ilisparrow/ProjetTPcapteur/Construction robot/montage_acc.jpg

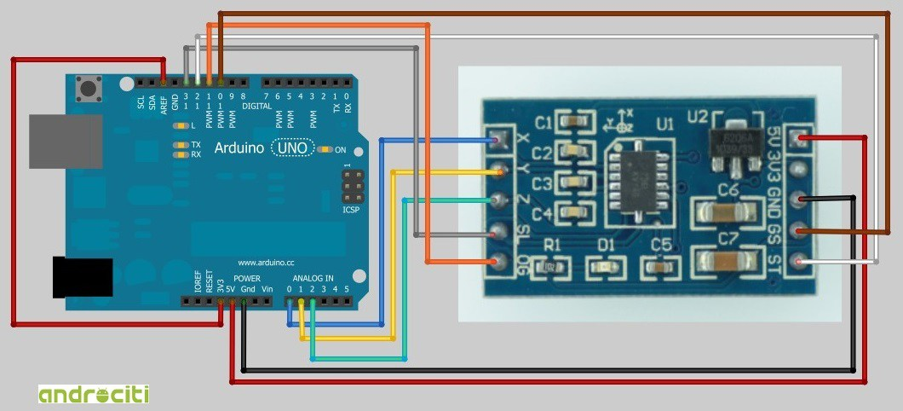
Construction robot/montage_acc.jpg
