ilisparrow/ProjetTPcapteur/Construction robot/4.jpg

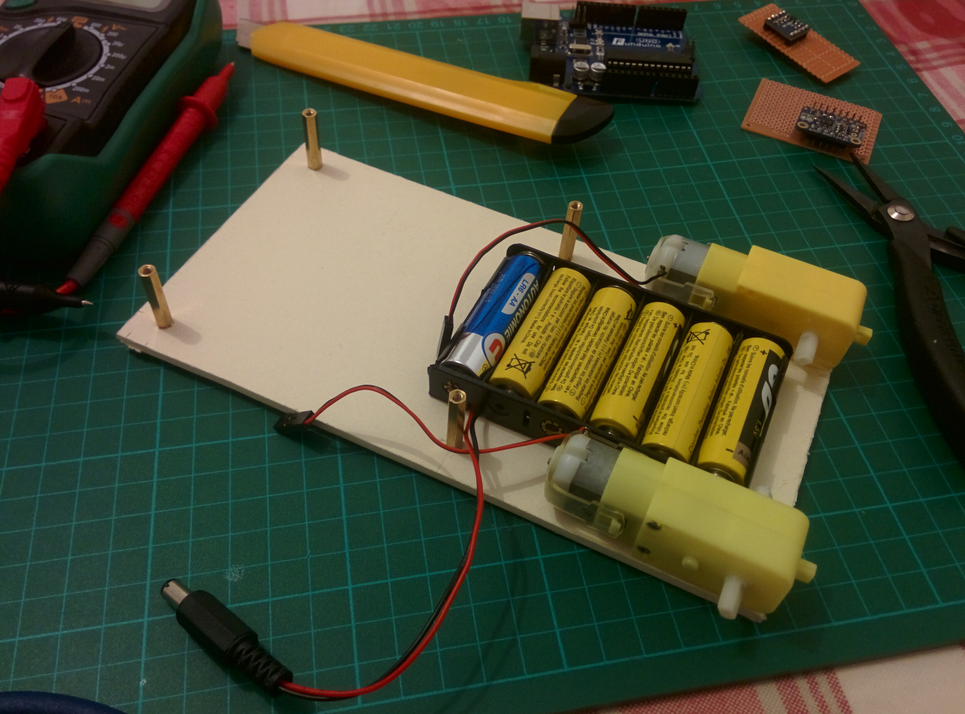
Construction robot/4.jpg
