ilisparrow/ProjetTPcapteur/Construction robot/schema chassis.pptx

ACCELEROMETRE

ARDUINO
UNO

DRV8833

SUPPORT
PILE

MOTEUR
