ilisparrow/ProjetTPcapteur/fonctionnement_DRV8833/fonctionnement_DRV8833.docx

UTILISATION DRV8833

I - Montage

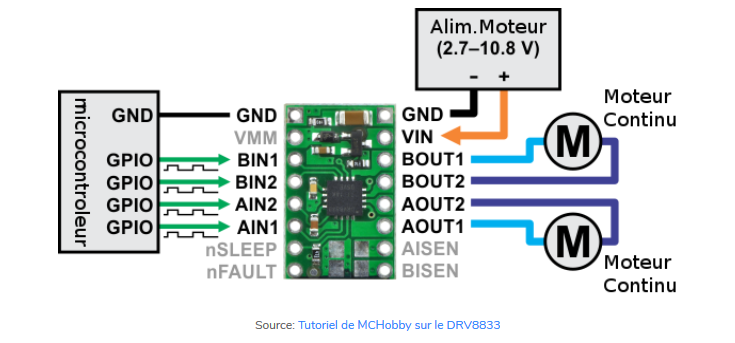
[picture p3: figure]

Référence moteur

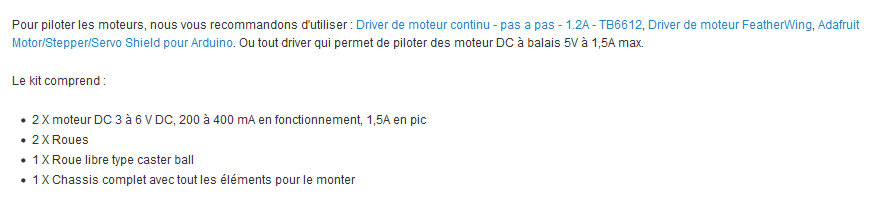
[picture p4: figure]

Principe de fonctionnement

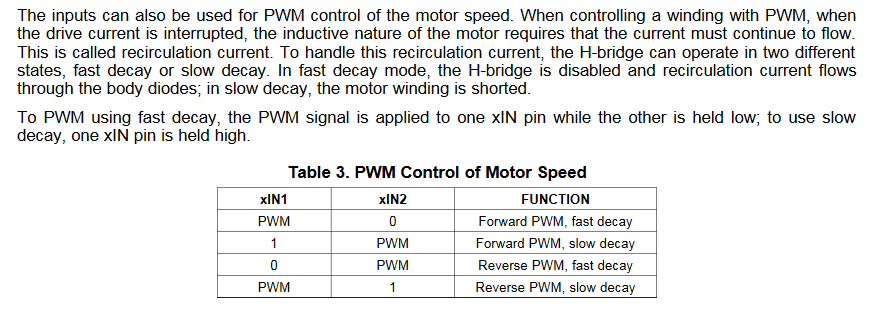
[picture p5: figure]

SOURCE

https://arduino103.blogspot.fr/2014/09/drv8833-piloter-facilement-des-moteurs.html

https://boutique.semageek.com/fr/843-mini-kit-chassis-de-robot-2wd-avec-moteurs-dc.html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
