ilisparrow/ProjetTPcapteur/Construction robot/1.jpg

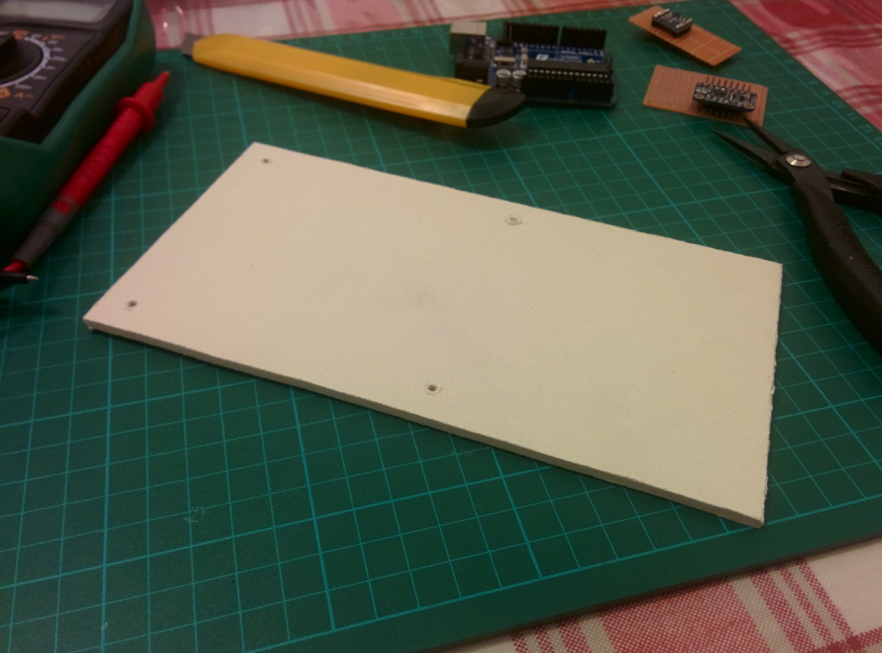
Construction robot/1.jpg
