ilisparrow/ProjetTPcapteur/Construction robot/2.jpg

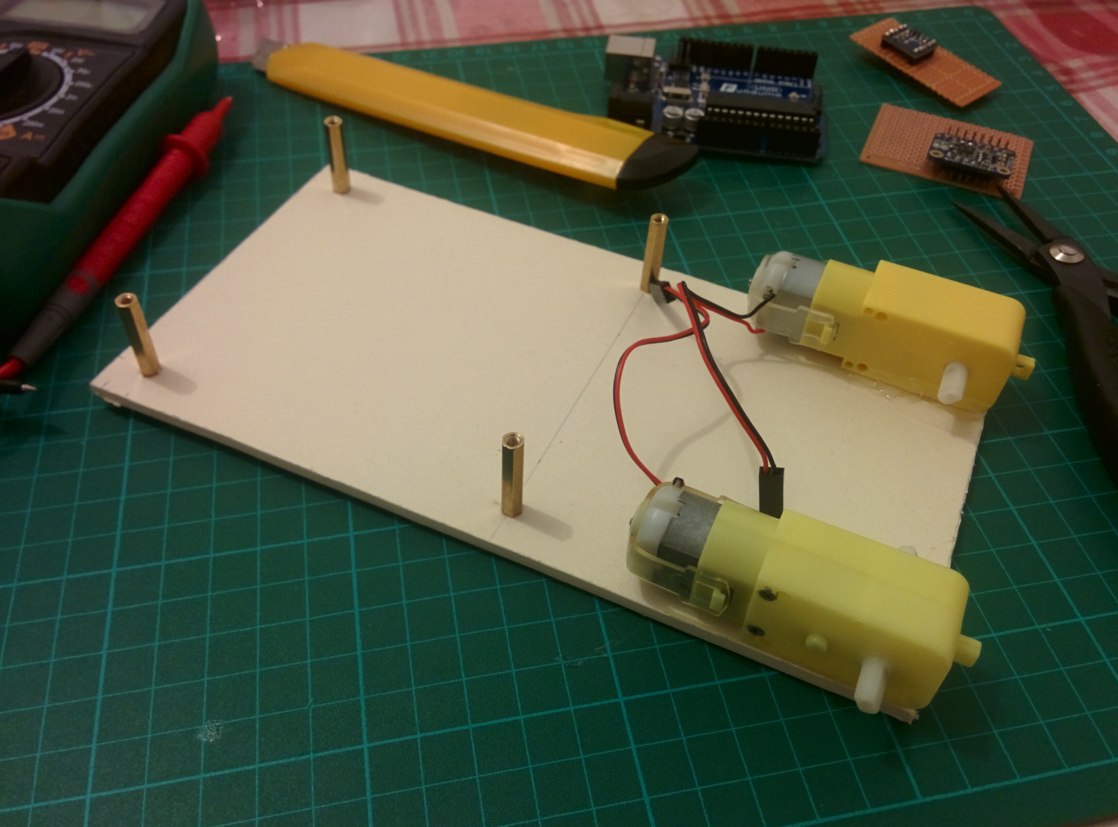
Construction robot/2.jpg
