ilisparrow/ProjetTPcapteur/Construction robot/3.jpg

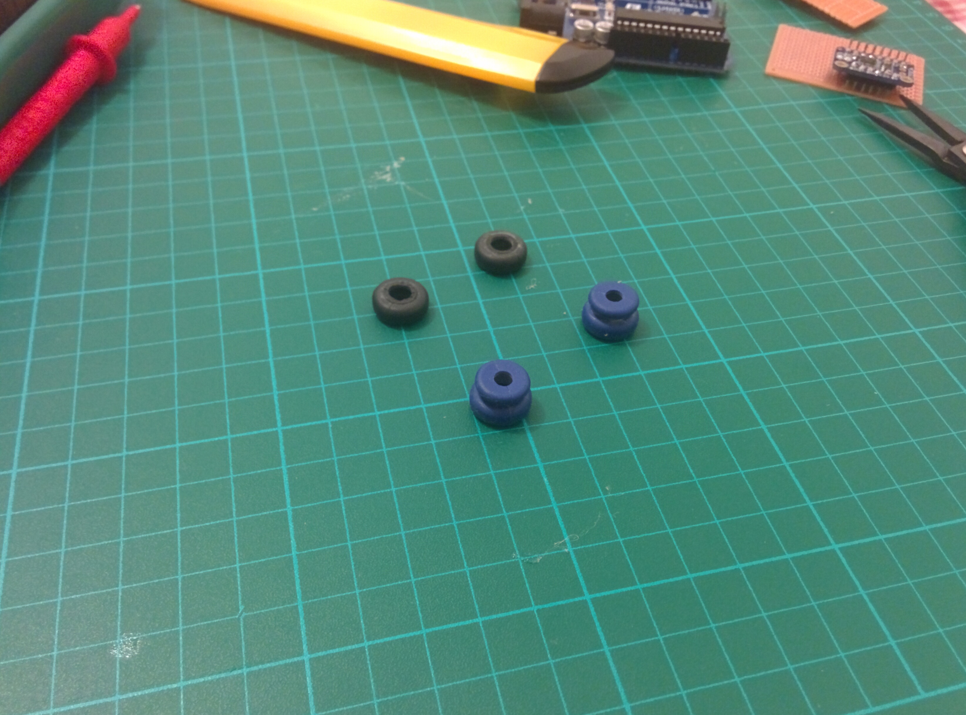
Construction robot/3.jpg
