ilisparrow/ProjetTPcapteur/Construction robot/5.jpg

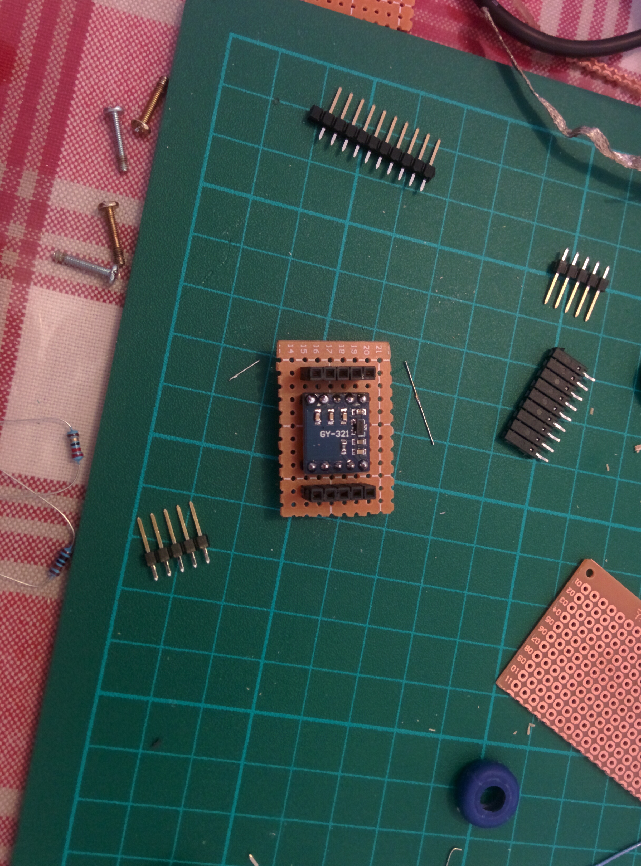
Construction robot/5.jpg
