ilisparrow/ProjetTPcapteur/Construction robot/6.jpg

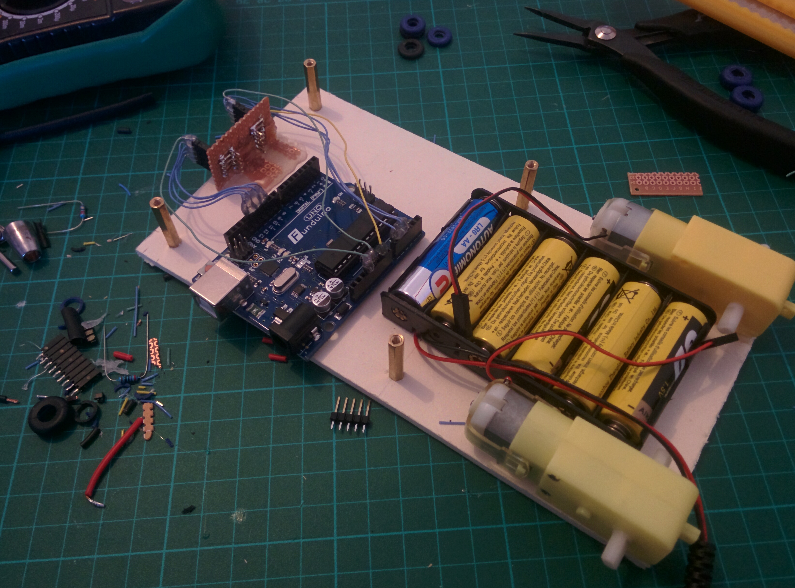
Construction robot/6.jpg
