ilisparrow/ProjetTPcapteur/Construction robot/7.jpg

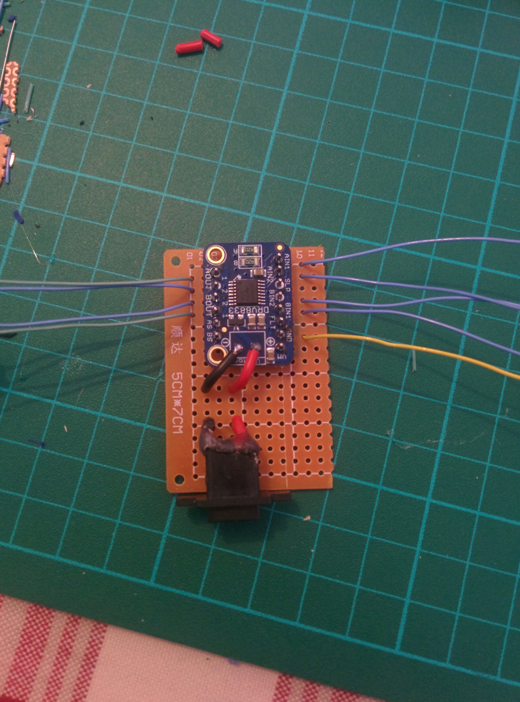
Construction robot/7.jpg
