ilisparrow/ProjetTPcapteur/(commit log)

2017-11-20 Auto stash before merge of "master" and "origin/master"
    rajout bib arduino accelerometre
2017-11-20 Doc pour driver DRV8833
2017-11-20 Create implémentation PID sous ARDUINO
2017-11-20 amelioration du reseau de neurone, se compile mais je sais pas si c'est fonctionnel.
2017-11-27 Déroulement construction robot
    Décrit les matériaux utilisés, le montage du robot et quels pins sont utilisés
    [pin planner.xlsx]
2017-11-27 Derniere seance de tp
2017-12-04 Semi final [Reseau de neurones]
2017-12-04 rien de special, changementd'ordi
